prabinrath/Roborex_Chess/utils/img_ui.jpg

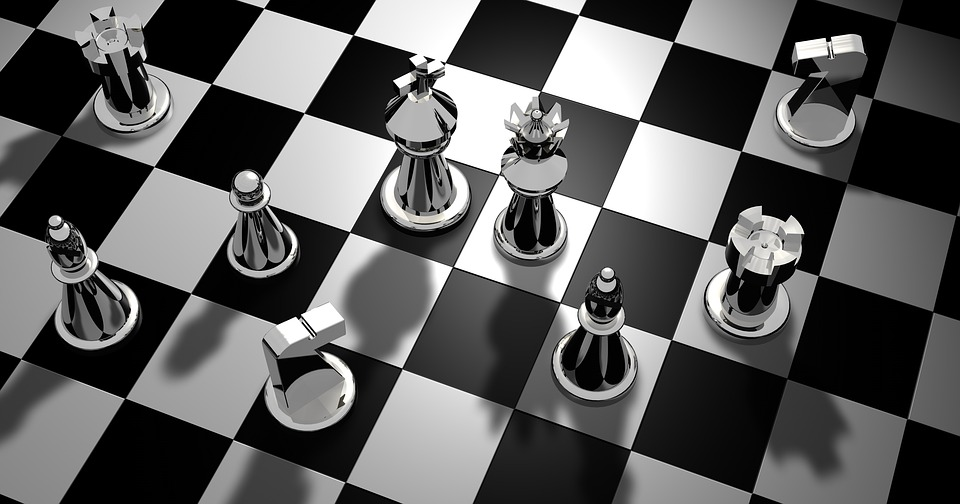
utils/img_ui.jpg
