prabinrath/Roborex_Chess/utils/chess.png

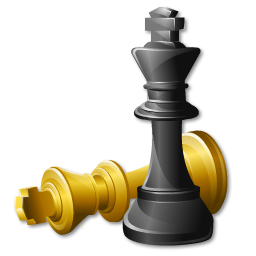
utils/chess.png
