prabinrath/Roborex_Chess/arduino_file/interrupt_/interrupt_.ino

#include <Stepper.h>
#include<ctype.h>
int ir_pin_y = 3,ir_pin_x=2,i=1;
int counter = 0;
unsigned long previous=0,current;

const int stepsPerRevolution = 200;
Stepper x_(stepsPerRevolution, 4, 5, 6, 7);
Stepper y_(stepsPerRevolution, 11, 10, 9, 8);

void setup()
{ 
  y_.setSpeed(10);
  x_.setSpeed(10);

  pinMode(ir_pin_y, INPUT);
  pinMode(ir_pin_x, INPUT);
  pinMode(12,OUTPUT);
  Serial.begin(9600);
  attachInterrupt(digitalPinToInterrupt(ir_pin_y),IRQcounter, CHANGE);
  attachInterrupt(digitalPinToInterrupt(ir_pin_x),IRQcounter, CHANGE);
  
  digitalWrite(A0,LOW);
  delay(1000);
}


void IRQcounter()
{
  current=millis();
  if(current-previous>30)
    {
      counter++;
    Serial.println(counter);
    }
  previous=current;
}

String steps="",s="";
int task=0;

void loop()
{
  if(Serial.available())
    {
      steps=Serial.readString();
      if(isAlpha(steps[0]))
      {
        s=steps;
      }
      else if(steps=="o")
        digitalWrite(A0,HIGH);
      else if(steps=="f")
        digitalWrite(A0,LOW);
      else 
      {
        task=steps.toInt();
        counter=0;
      }
    }
      if(s[0]=='y')
      {
        if(task>0 && counter<task)
          y_.step(1);
        else if(task<0 && counter<abs(task))
          y_.step(-1);
      }
      else if(s[0]=='x')
      {
        if(task>0 && counter<task)
          x_.step(1);
        else if(task<0 && counter<abs(task))
          x_.step(-1);
      }
}
